ueceu/Graduation-Project/complete.png

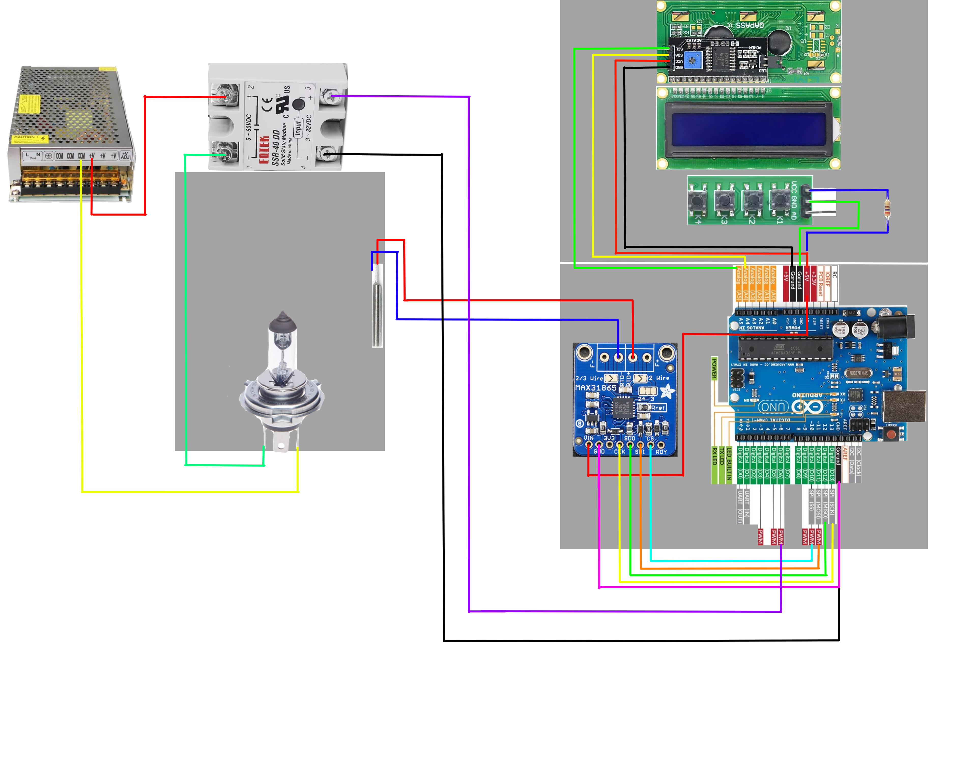
complete.png
