ueceu/Graduation-Project/bulb, power, relay, arduino.png

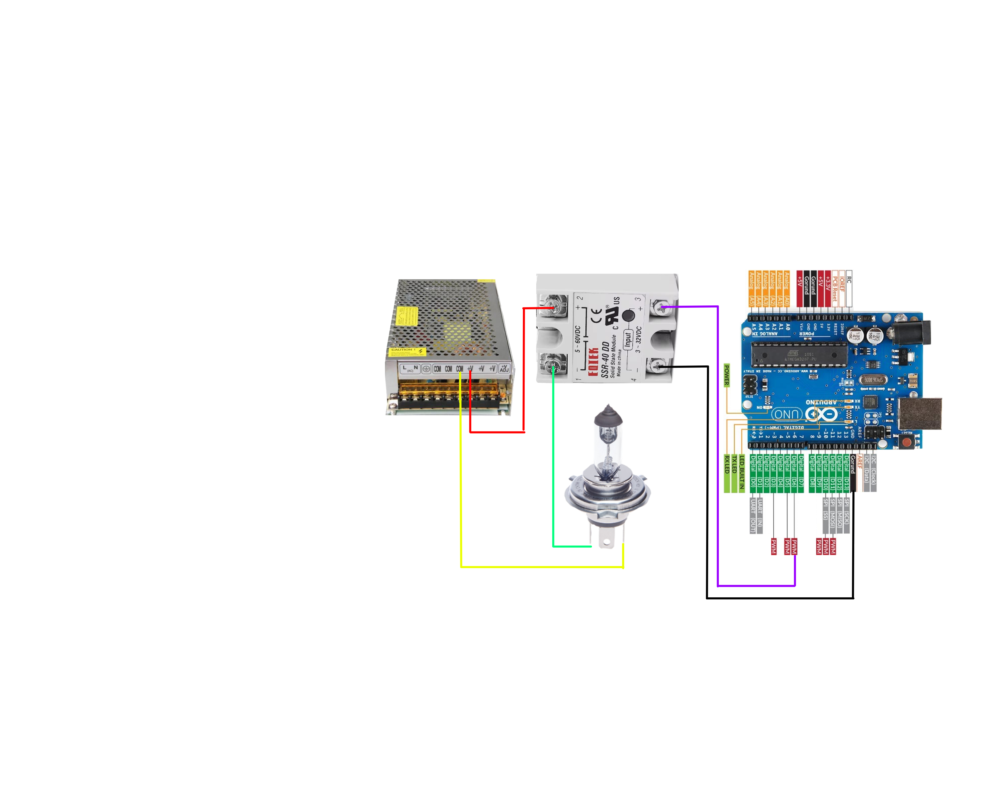
bulb, power, relay, arduino.png
