ueceu/Graduation-Project/lcd.png

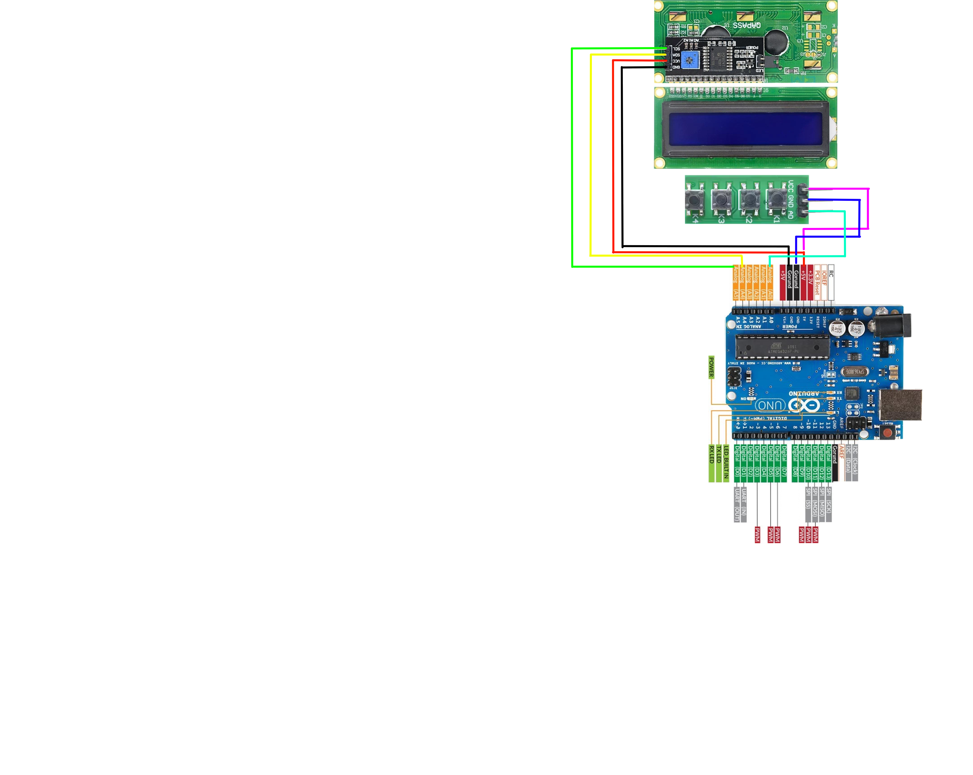
lcd.png
