ueceu/Graduation-Project/Max, pt100, arduino.png

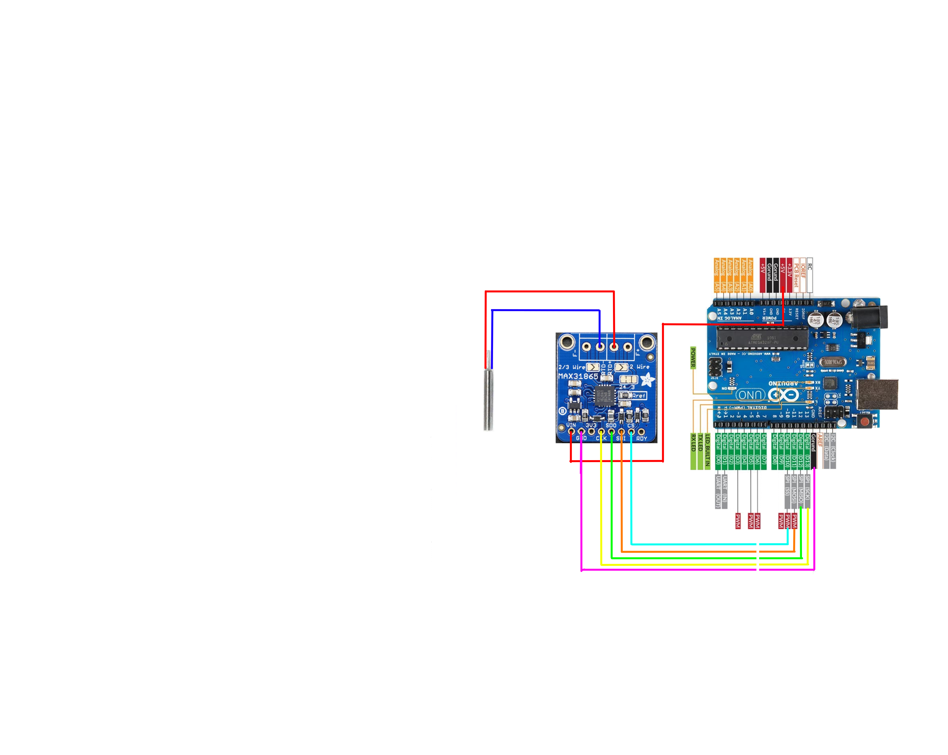
Max, pt100, arduino.png
